danny50818/xc90-smart-car-knob/HARDWARE.md

# 硬體與接線資料

完整採購清單已整合到專案首頁的 [`README.md`](README.md#完整硬體清單)。本頁保留接腳與電源接線的快速查閱資料。

## 模型五金與回收零件

| 項目 | 數量 | 用途 |
| --- | ---: | --- |
| M3 × 4 mm 螺絲 | 2 | 外殼組裝 |
| M3 × 12 mm 螺絲 | 2 | 外殼組裝 |
| M3 熱熔螺母 | 4 | 壓入列印件 |
| M2.5 × 4 mm 螺絲 | 3 | 模組與模型固定 |
| 原車聽筒磁鐵 | 4 | 從舊聽筒拆下保留，於磁鐵槽封閉前暫停列印並放入 |

磁鐵的內埋暫停層數不是固定值；請以當次切片預覽確認磁鐵槽即將被封閉的位置。放入時須保持與原車相同的朝向與極性，並確認磁鐵不會高出列印面或被噴頭碰到。

## FPC 電源腳位

觀察方向：**轉接／測試板正面、凸起的 FPC 插座朝下，排線由下方插入。** 此方向下接點由右至左編為 Pin 1～Pin 10。

| Pin | 功能 | 接法 |
| ---: | --- | --- |
| 1 | +5V | 接 5V 電源正極 |
| 3 | GND | 接電源負極／接地 |
| 2、4～10 | 未確認 | 不接 5V |

FPC 電源接線圖

翻到背面觀看會左右鏡像反轉。通電前仍應以萬用表確認極性。

## 已確認 GPIO

| 功能 | ESP32-S3 GPIO |
| --- | --- |
| SH8601 CS | 12 |
| SH8601 CLK | 10 |
| SH8601 D0 / D1 / D2 / D3 | 13 / 11 / 14 / 9 |
| 顯示 RST | 8 |
| 面板啟用 PANEL_EN | 17 |
| CST816S SDA / SCL | 1 / 3 |
| CST816S RST / INT | 2 / 4 |
| 編碼器 A / B | 6 / 5 |
| 編碼器按鍵 | 0 |
| 狀態 LED | 21 |

GPIO17 必須在 SH8601 初始化之前拉高。
