danny50818/xc90-smart-car-knob/models/xc90-phone-remote-v15.3mf

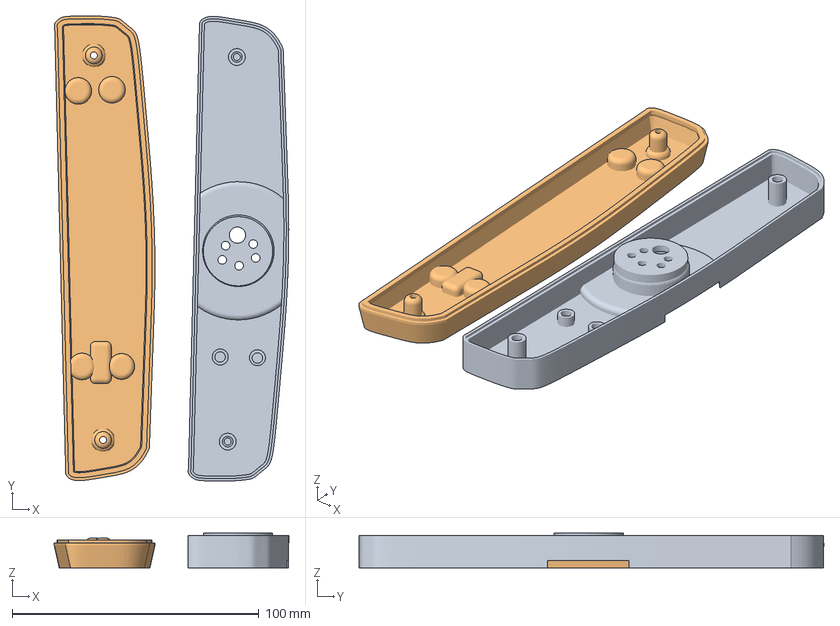
[picture p7: CAD file, 2026-10-22]
models/xc90-phone-remote-v15.3mf
95.0 x 188.4 x 14.0 mm
实体1
实体3
