danny50818/xc90-smart-car-knob/MAKERWORLD.md

# Volvo XC90 ESP32-S3 智慧車用旋鈕外殼

這是一套為 Volvo XC90 車內使用情境設計的智慧控制旋鈕外殼。模型用來安裝 ESP32-S3 圓形觸控旋鈕模組，完成後可透過 BLE HID 控制 Android 車機，不需要安裝額外 APK。

## 模型內容

下載的 v15 3MF 內含 2 個零件：

- 兩個長形外殼零件，尺寸約為 40.81 × 188.24 × 14.00 mm 與 40.81 × 188.24 × 12.00 mm。
- 新版已取消舊版獨立圓形旋鈕零件。
- 模型單位為毫米。

模型檔名：`xc90-phone-remote-v15.3mf`

## 所需五金

- M3 × 4 mm 螺絲 × 2
- M3 × 12 mm 螺絲 × 2
- M3 熱熔螺母 × 4
- M2.5 × 4 mm 螺絲 × 3
- 從原車聽筒拆下並保留的磁鐵 × 4

安裝熱熔螺母時請逐步加熱並保持垂直，避免溫度過高使孔位變形。不同列印材料的收縮率不同，正式鎖緊前建議先試裝。

## 電子硬體

- ESP32-S3 智慧旋鈕主模組 × 1
- 1.5 吋、466 × 466 圓形 IPS 電容觸控螢幕 × 1
- 10 Pin、0.5 mm FFC/FPC 排線 × 1
- 10 Pin、0.5 mm FFC/FPC 轉接／測試板 × 1
- 穩定 5V 電源及正、負極連接線

從轉接板正面觀看、凸起的 FPC 插座朝下時：Pin 1 接 +5V，Pin 3 接 GND。翻到背面後左右會鏡像反轉，通電前請用萬用表確認。

## 專案功能

圓形螢幕包含導航、觸控板、多媒體及系統快捷四個頁面。實體旋鈕可控制鍵盤上下選擇、滑鼠滾輪與音量；短按確認、雙擊返回、長按回首頁，按住旋轉可切換頁面。閒置時螢幕會休眠，但藍牙保持連線。

| 導航 | 觸控板 |
| --- | --- |
| 導航頁 | 觸控板頁 |
| 多媒體 | 系統快捷 |
| 多媒體頁 | 系統快捷頁 |

## 完整專案資料

韌體、接線圖、完整硬體清單、四頁 UI 預覽及模型說明：

https://github.com/danny50818/xc90-smart-car-knob

## 列印提醒

請依使用的材料、噴嘴及印表機自行調整層高、支撐與填充。切片前確認熱熔螺母孔、螺絲孔及排線通道方向；模型與電子模組尺寸請以實物試裝為準。

原車長條型聽筒位置示意

*網路上的示意圖，僅供參考。*

## 磁鐵內埋方式

1. 拆下原車長條型聽筒，小心取出並保留 4 顆磁鐵。
2. 在切片預覽中找到磁鐵槽即將被封閉的位置，並在前一層設定列印暫停。層數會隨層高與切片設定改變。
3. 暫停後依原車方向與極性放入 4 顆磁鐵，確認完全壓入且不會碰到噴頭，再繼續列印。

> 安裝前請記錄原車磁鐵的朝向與極性，4 顆都要保持與原車安裝方式一致。
