danny50818/xc90-smart-car-knob/(commit log)

2026-10-18 Add XC90 smart knob firmware, hardware guide, and 3D model
    [xc90-phone-remote-v13.3mf]
2026-10-22 Document hardware, FPC wiring, UI previews, and MakerWorld listing
2026-10-22 Update v15 enclosure model and assembly guide
    [xc90-phone-remote-v13.3mf, xc90-phone-remote-v15.3mf]
